SREE-VISHNU-N/STM32-PCB/STM32 PCB/FOOTPRINTS/629105150521 (rev1).stp

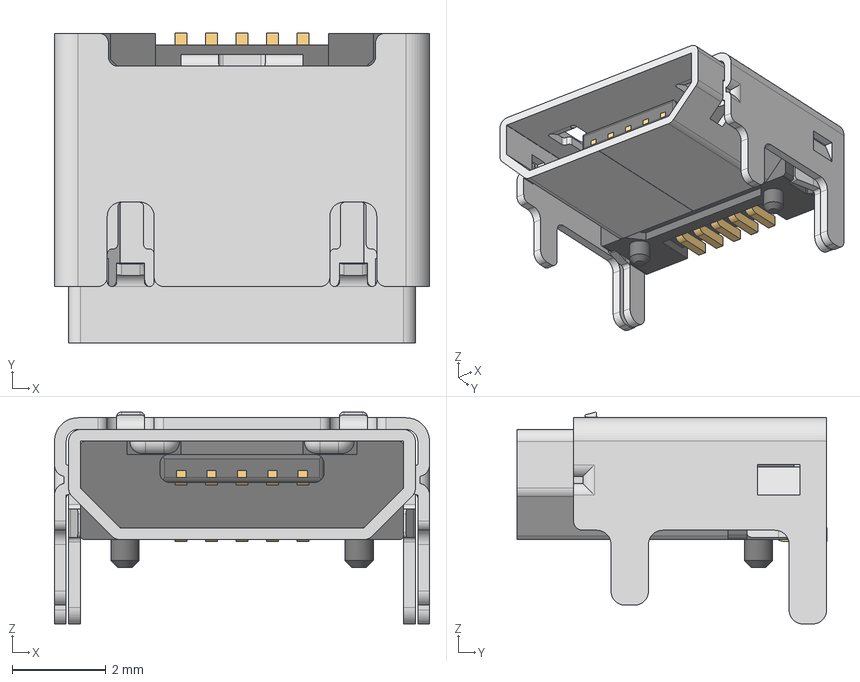
[picture p1: CAD file, 2025-01-17]
STM32 PCB/FOOTPRINTS/629105150521 (rev1).stp
8.00 x 6.60 x 4.52 mm
629105150521_Housing
629105150521_Pin1 x 4
629105150521_Pin2
629105150521_Shielding2
629105150521_Shielding
