SREE-VISHNU-N/STM32-PCB/STM32 PCB/STM32 Hardware.kicad_pcb

## KiCad design STM32 PCB/STM32 Hardware.kicad_pcb (2025-01-17)

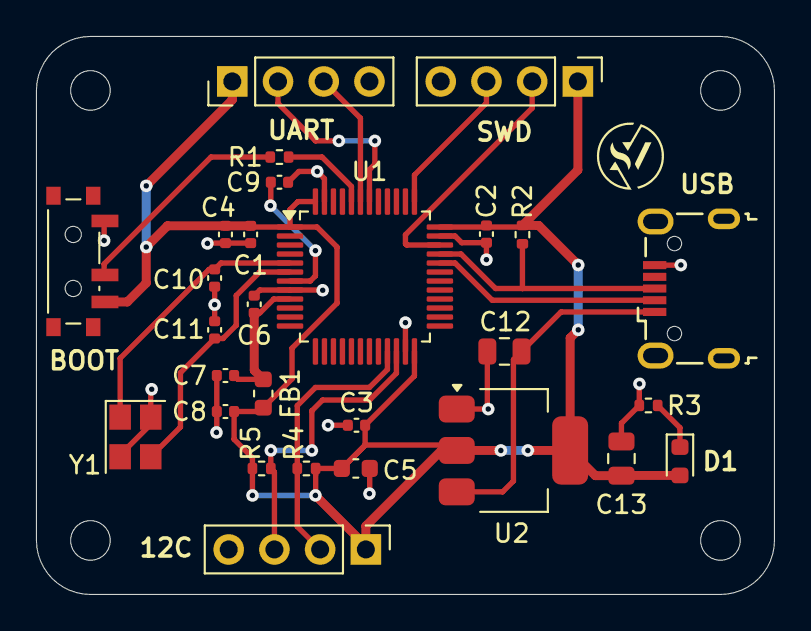
[picture p2: board STM32 Hardware.kicad_pcb from above]

Board: 2 copper layers, 41.0 x 31.0 mm, 32 parts (0 on the bottom side), 18 nets.

Parts:
12C: Conn_01x04_Pin; PinHeader_1x04_P2.54mm_Vertical
BOOT: SW_SPDT; SW_SPDT_PCM12_V2
C1, C2, C3, C4, C9: 100n; C_0402_1005Metric
C5: 10u; C_0603_1608Metric
C6: 10n; C_0402_1005Metric
C7, C8: 1u; C_0402_1005Metric
C10, C11: 10p; C_0402_1005Metric
C12, C13: 22u; C_0805_2012Metric
D1: RED; LED_0603_1608Metric
FB1: 120R; L_0603_1608Metric
H1, H2, H3, H4: MountingHole; MountingHole_2.2mm_M2
R1: 10k; R_0402_1005Metric
R2, R3, R4, R5: 1k5; R_0402_1005Metric
SWD: Conn_01x04_Pin; PinHeader_1x04_P2.54mm_Vertical
U1: STM32F103C8T6; LQFP-48_7x7mm_P0.5mm
U2: AMS1117-3.3; SOT-223-3_TabPin2
UART: Conn_01x04_Pin; PinHeader_1x04_P2.54mm_Vertical
USB: USB_B_Micro; USB_Micro-B_Wuerth_629105150521
Y1: 16MHz; Crystal_SMD_3225-4Pin_3.2x2.5mm

Connections:
+3.3V: 12C.1, BOOT.3 (C), C1.1, C2.1, C3.1, C4.1, C5.1, C8.1, C13.1, D1.2 (A), FB1.2, R2.1, R4.1, R5.1, SWD.1, U1.1 (VBAT), U1.24 (VDD), U1.36 (VDD), U1.48 (VDD), U2.2 (VO), UART.1
+3.3VA: C6.1, C7.1, FB1.1, U1.9 (VDDA)
/BOOT0: R1.2, U1.44 (BOOT0)
/HSE_IN: C10.1, U1.5 (PD0), Y1.1
/HSE_OUT: C11.1, U1.6 (PD1), Y1.3
/I2C2_SCL: 12C.2, R4.2, U1.21 (PB10)
/I2C2_SDA: 12C.3, R5.2, U1.22 (PB11)
/NRST: C9.1, U1.7 (NRST)
/PWR_LED_K: D1.1 (K), R3.1
/SWCLK: SWD.3, U1.37 (PA14)
/SWDIO: SWD.2, U1.34 (PA13)
/SW_BOOT0: BOOT.2 (B), R1.1
/USART1_RX: U1.43 (PB7), UART.3
/USART1_TX: U1.42 (PB6), UART.2
/USB_D+: R2.2, U1.33 (PA12), USB.3 (D+)
/USB_D-: U1.32 (PA11), USB.2 (D-)
GND: 12C.4, BOOT.1 (A), C1.2, C2.2, C3.2, C4.2, C5.2, C6.2, C7.2, C8.2, C9.2, C10.2, C11.2, C12.2, C13.2, R3.2, SWD.4, U1.8 (VSSA), U1.23 (VSS), U1.35 (VSS), U1.47 (VSS), U2.1 (GND), UART.4, USB.5 (GND), Y1.2, Y1.4
VBUS: C12.1, U2.3 (VI), USB.1 (VBUS)
